premakumarahps/automotive-gearbox-machine-design/public/docs/ME3813_Presentation_Group11.pdf

# GEAR BOX

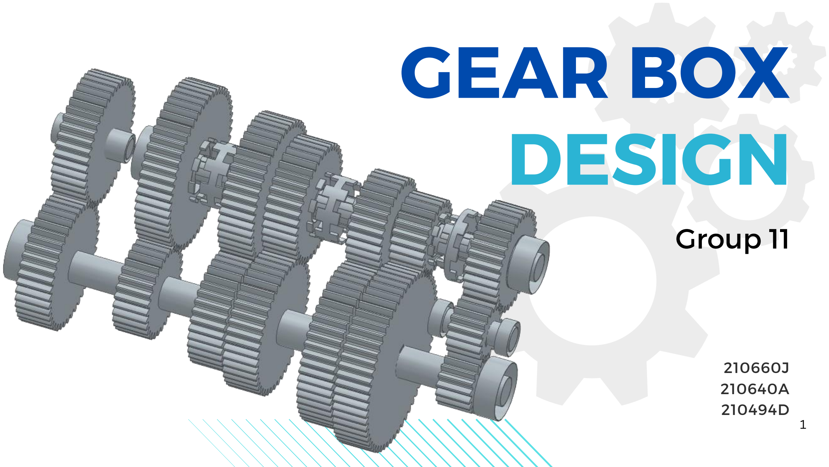
[picture p88: page 1]

# DESIGN

210660J
210640A
210494D

## Group 11

1

# VEHICLE SELECTION

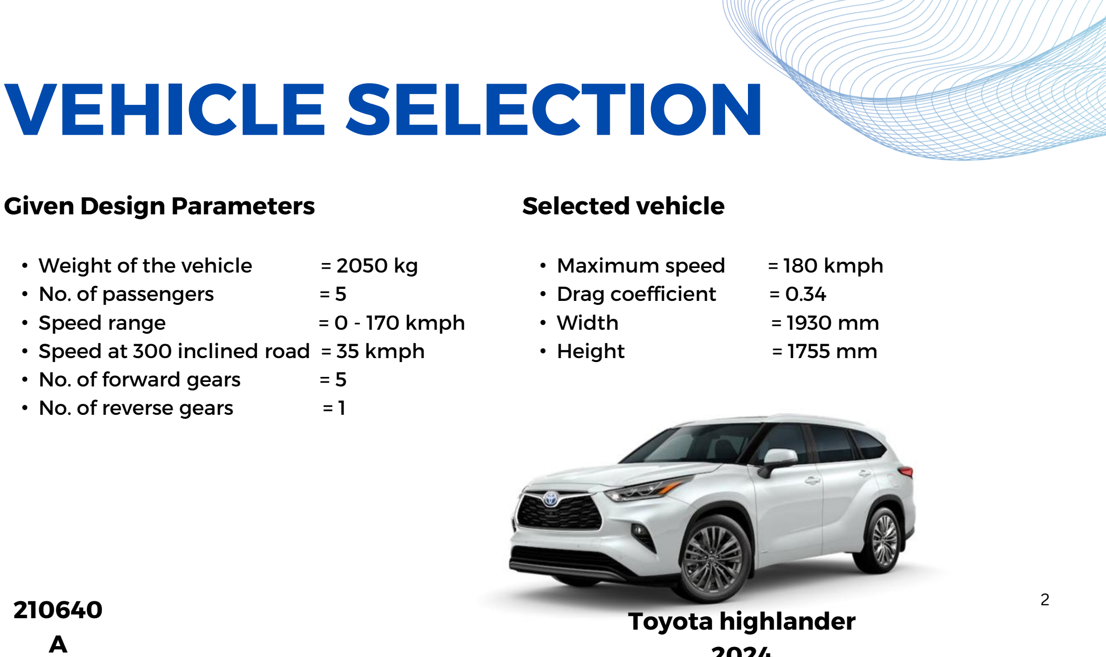
[picture p89: page 2]

Given Design Parameters

- Weight of the vehicle | = 2050 kg
- No. of passengers | = 5
- Speed range | = 0 - 170 kmph
- Speed at 300 inclined road = 35 kmph
- No. of forward gears | = 5
- No. of reverse gears | = 1

Selected vehicle

- Maximum speed | = 180 kmph
- Drag coefficient | = 0.34
- Width | = 1930 mm
- Height | = 1755 mm

2
210640
A

Toyota highlander
2024

# GEAR RATIO CALCULATION

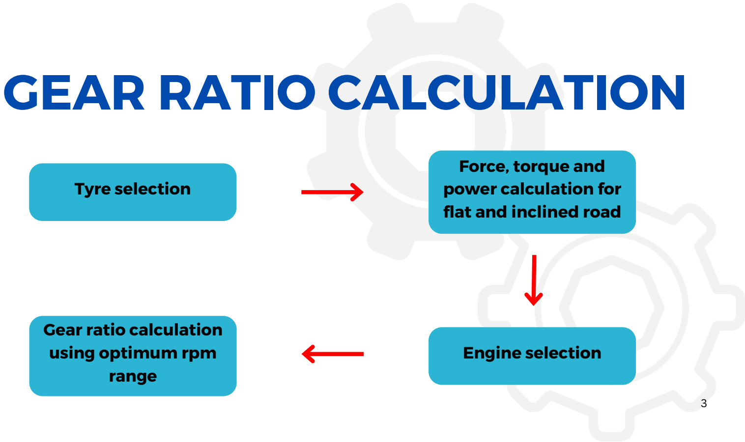
[picture p90: page 3]

Tyre selection

Force, torque and
power calculation for
flat and inclined road

Engine selection

Gear ratio calculation
using optimum rpm
range

3

# GEAR CALCULATION

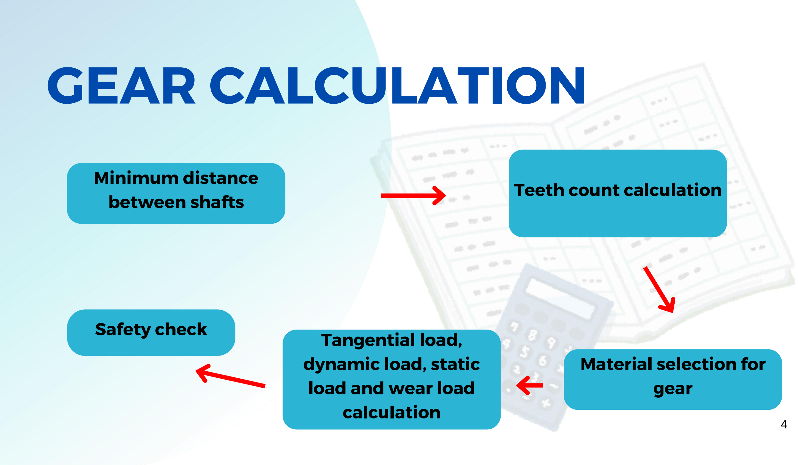
[picture p91: page 4]

Minimum distance
between shafts | Teeth count calculation

Material selection for
gear

Safety check
Tangential load,
dynamic load, static
load and wear load
calculation
4

# SHAFT CALCULATION

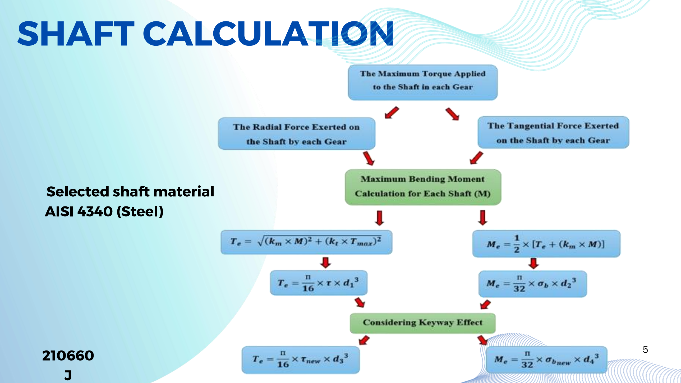
[picture p92: page 5]

Selected shaft material
AISI 4340 (Steel)

5
210660
J

# BENDING MOMENT CALCULATION

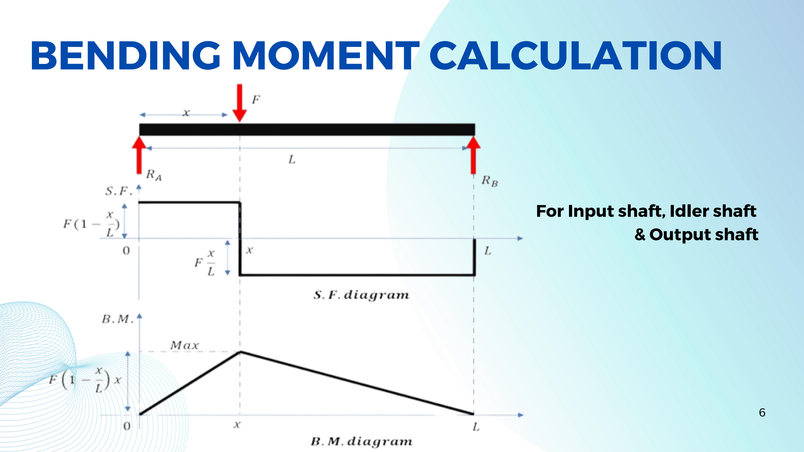
[picture p93: page 6]

For Input shaft, Idler shaft & Output shaft

6

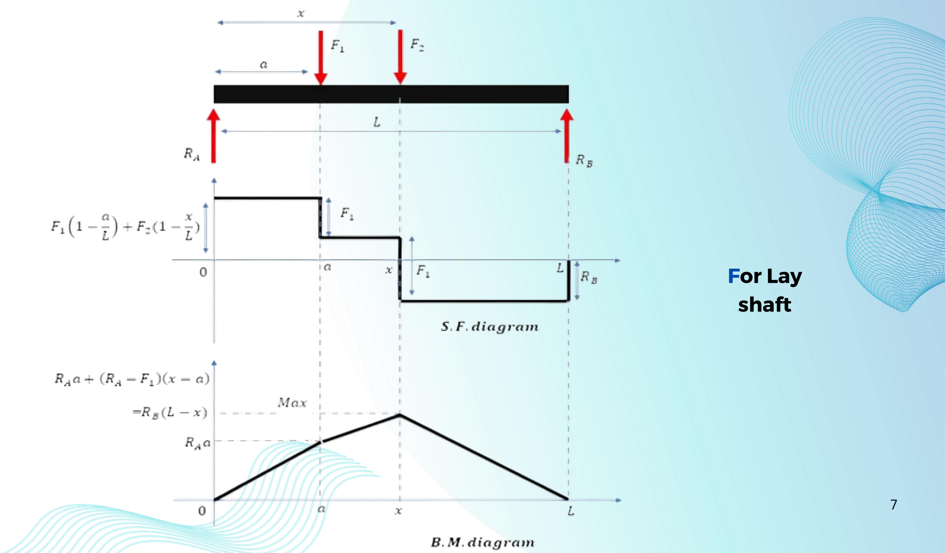
[picture p94: page 7]

For Lay
shaft

7

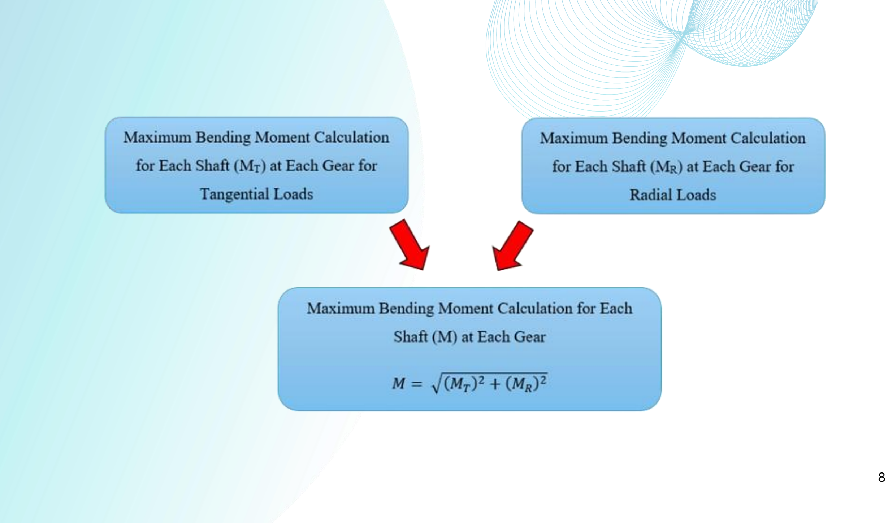
[picture p95: page 8]

8

# BEARING CALCULATIONS

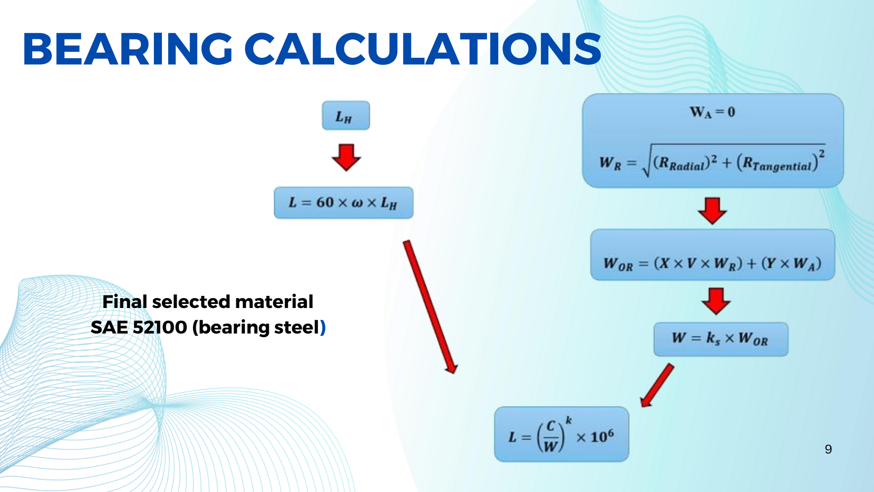
[picture p96: page 9]

Final selected material
SAE 52100 (bearing steel)

9

# SPLINE CALCULATION

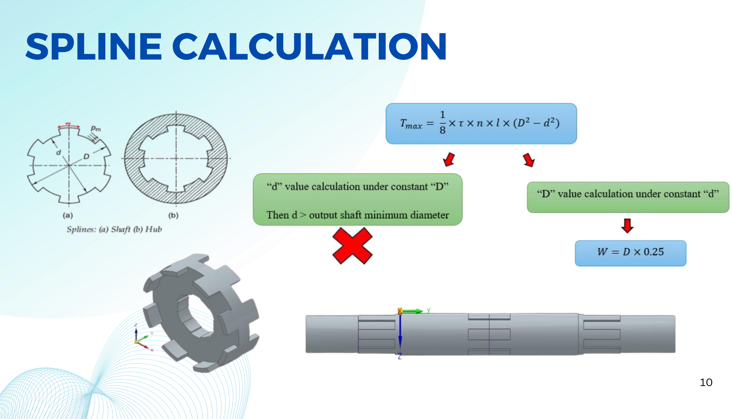
[picture p97: page 10]

10

# KEY CALCULATIONS

Determining width and
thickness

Calculating length

Keyway effect
calculation

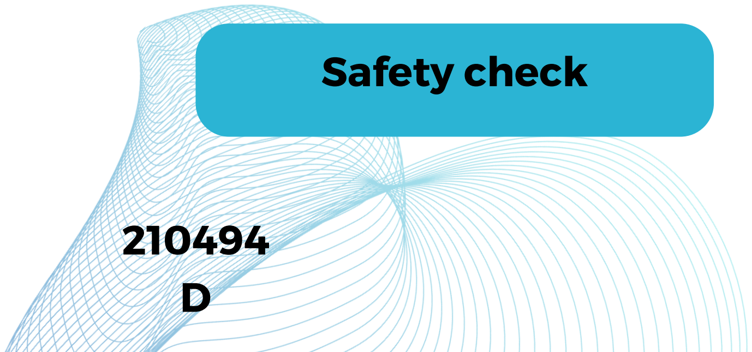
[picture p98: figure]
Safety check

210494 11

# LUBRICATION SYSTEM

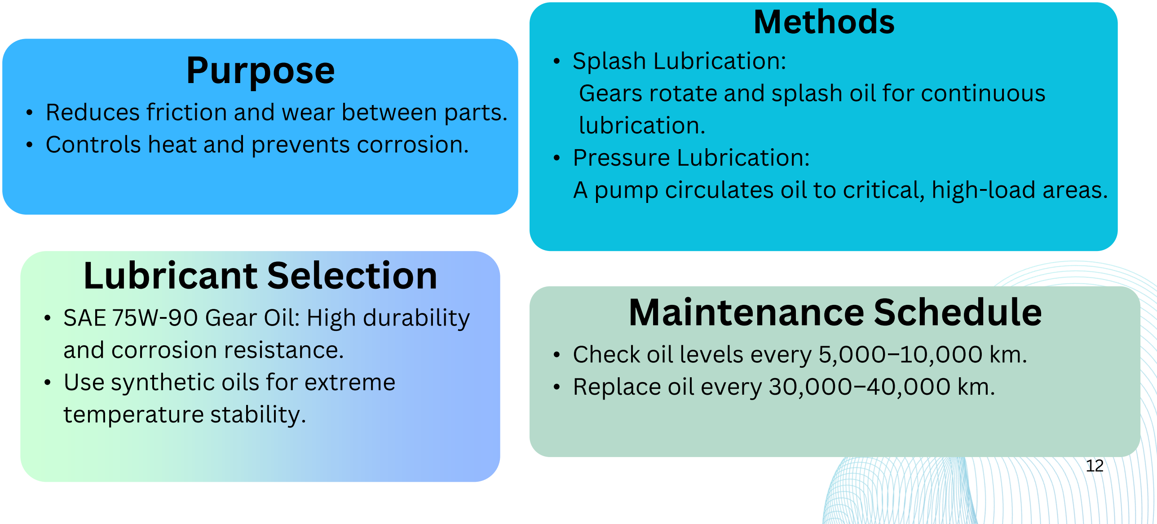
[picture p99: figure]
Maintenance Schedule; • Replace oil every 30,000–40,000 km.; Lubricant Selection; • SAE 75W-90 Gear Oil: High durability and corrosion resistance. • Use synthetic oils for extreme temperature stability.; Methods; • Splash Lubrication:; lubrication. • Pressure Lubrication:; Purpose; • Controls heat and prevents corrosion.

- Check oil levels every 5,000–10,000 km.

Gears rotate and splash oil for continuous

A pump circulates oil to critical, high-load areas.

- Reduces friction and wear between parts.

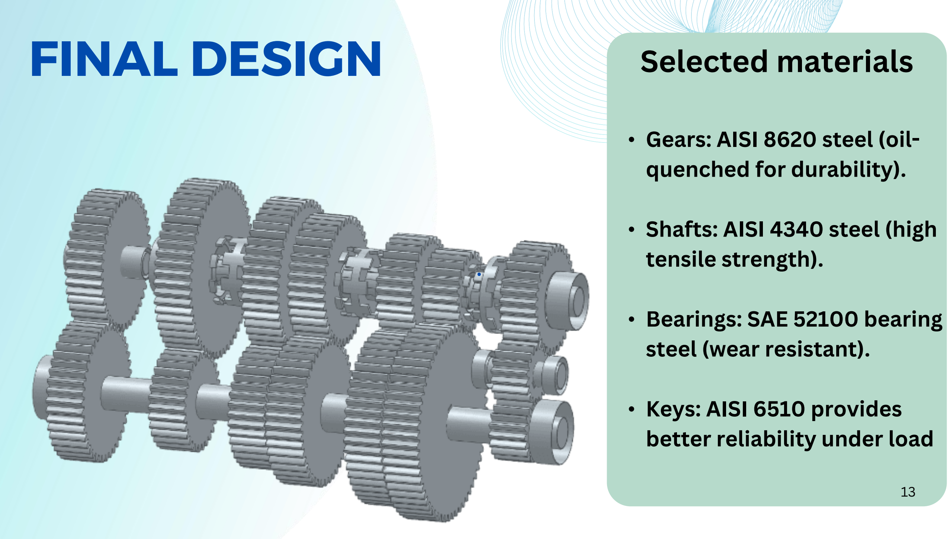
[picture p100: page 13]

FINAL DESIGN | Selected materials
- Gears: AISI 8620 steel (oil-quenched for durability).
- Shafts: AISI 4340 steel (high tensile strength).
- Bearings: SAE 52100 bearing steel (wear resistant).
- Keys: AISI 6510 provides better reliability under load

13

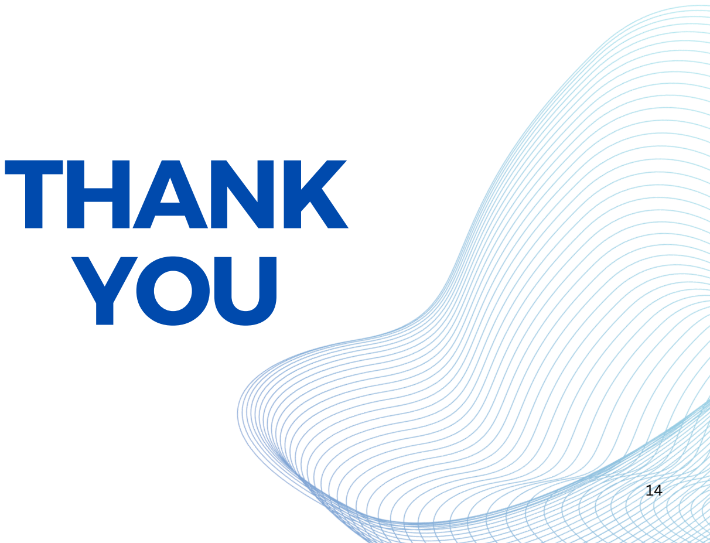
[picture p101: page 14]

# THANK YOU

14
