premakumarahps/automotive-gearbox-machine-design/public/docs/ME3813_Material_Selection.pdf

ME3813

## ME3813 Machine Design

## Semester 5

## Material Selection for Gearbox Components

By

Index No. | Name | Marks
210660J | UDAYAKANTHA D.A.W.I.
210640A | THEMIYA K.L.
210494D | PREMAKUMARA H.P.S.
Date of submission | 09/10/2024
Due date of submission | 09/10/2024

Department of Mechanical Engineering University of Moratuwa
Sri Lanka

### 01. INTRODUCTION

A gearbox is an essential mechanical system designed to transmit and modify rotational

energy from an engine to a driven component, effectively adjusting speed and torque. Given

the high stresses, friction, and temperature variations experienced during operation, the

selection of suitable materials is critical to ensuring the gearbox's reliability, performance,

and longevity. The chosen materials must possess specific mechanical properties, such as

strength, wear resistance, and fatigue endurance, to withstand harsh operating conditions

without failure. In addition to performance, the materials must be cost-effective,

manufacturable, and sustainable to ensure efficient production while meeting industry

standards and enhancing the overall performance of the gearbox.

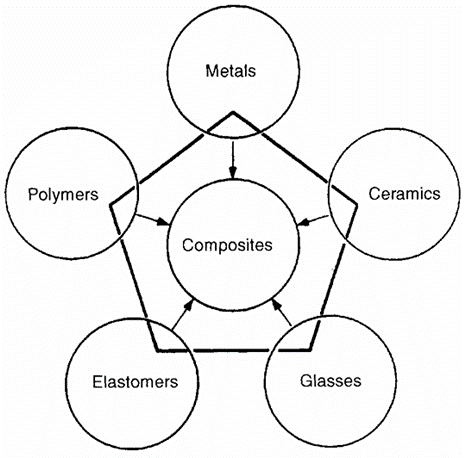
[picture p134: figure]

Figure 01: Types of materials [2]

02.MATERIAL PROPERTIES AND REQUIREMENTS

### 2.1 Mechanical properties

Mechanical properties are critical in determining how well a material can withstand forces and

stresses during operation. For gearbox components, essential properties include strength, which

ensures the material can handle loads without deforming; wear resistance, which is vital for

reducing material loss in high-friction areas like gears and bearings; and fatigue endurance,

which enables materials to resist failure after repeated cycles of stress over time.

### 2.2 Thermal properties

The thermal properties of materials dictate their performance under varying temperatures, a

common condition in gearboxes. High thermal conductivity is important to dissipate heat efficiently and avoid overheating. Materials with low thermal expansion help maintain their

dimensional stability despite temperature fluctuations, which is necessary to prevent

misalignment or damage in tightly-fitted components. Heat resistance ensures the material

remains strong and functional even at elevated operating temperatures.

### 2.3 Chemical properties

Chemical properties affect how materials interact with their environment, especially when

exposed to lubricants and other chemicals. Corrosion resistance is vital to protect materials

from degrading when exposed to moisture or chemicals, prolonging the life of components.

Oxidation resistance is equally important, particularly for materials used in high-temperature

environments, as it prevents deterioration from oxygen exposure, which can weaken

components over time.

### 2.4 Cost and availability

Cost and availability play a practical role in selecting materials. The chosen material should

provide the required performance at a reasonable cost to ensure economic feasibility, especially

in large-scale production. Additionally, the material should be readily available in sufficient

quantities to meet manufacturing demands without delays or supply chain issues, making it

more reliable for ongoing production.

### 2.5 Manufacturability

Manufacturability refers to the ease with which materials can be processed into final

components. Good machinability is essential for reducing production time and costs, allowing

materials to be efficiently cut, shaped, or drilled. Formability ensures materials can undergo

processes like casting or forging to achieve the desired shapes. Heat treatability allows

materials to be improved through thermal processes, enhancing their strength or wear resistance

where needed, especially for critical components like gears.

### 2.6 Durability and safety

Durability and safety are essential considerations for ensuring that gearbox components can

withstand prolonged use without failure. Durability involves the material’s ability to resist

wear, fatigue, and impact over time. Fatigue strength is particularly important for parts subject to cyclic loading, ensuring they do not crack or break under repeated stresses. Safety factors

ensure materials can handle unexpected loads or harsh conditions without failure, contributing

to the overall reliability of the system.

### 2.7 Environmental and sustainable factors

Sustainability is becoming an increasingly important consideration in material selection.

Recyclability is a key factor, as materials that can be repurposed or recycled at the end of their

lifecycle help reduce environmental impact. Energy efficiency, both in material production and

during operation, is another important aspect, as it can lower overall energy consumption.

Finally, using sustainably sourced materials helps ensure that environmental resources are

managed responsibly, aligning with industry trends towards greener production methods.

03.MATERIAL SELECTION FOR EACH COMPONENT

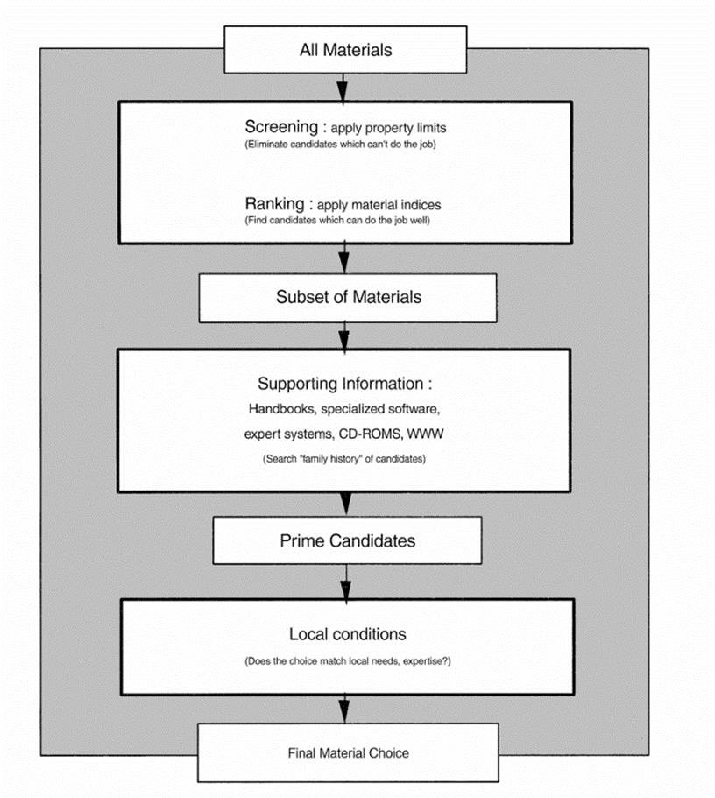
[picture p135: figure]

Figure 02 : Material selection procedure [2]

3.1GEARS

Material requirements :- High strength ,Wear resistance, Fatigue resistance, Toughness

Material options :- AISI 8620 (alloy steel), AISI 4140 (alloy steel), AISI 4340 (nickel-

chromium-molybdenum steel) [Figure 04] , [2] , [7] , [3] , [1]

Final selection - AISI 8620 (alloy steel, case-hardened)

This alloy steel offers excellent core toughness and can be case-hardened to improve surface

wear resistance. AISI 4140 or 4340 are also strong, tough steels but can be over-engineered or

expensive for standard gears.

Manufacturing considerations :- Case hardening to achieve a tough core and hard surface,

Precision machining for tooth profile accuracy, Surface finish for noise reduction

3.2SHAFTS

Material requirements :- High tensile strength, Toughness, Fatigue resistance, Machinability

Material options :- AISI 1045 (medium carbon steel), AISI 4140 (alloy steel), AISI 4340

(alloy steel) [Figure 04] , [2] , [7] , [1] , [6] , [Figure 06]

Final selection - AISI 1045 (medium carbon steel)

Medium carbon steel like AISI 1045 offers a good balance of machinability and strength, and

it can be heat-treated for better performance. AISI 4140 offers higher strength but may be

unnecessary for lower-stress applications.

Manufacturing considerations :- Easily machined, Heat-treatable for strength improvement,

Suitable for turning, Grinding, Drilling

3.3BEARINGS

Material requirements :- High wear resistance, Hardness, Fatigue strength, Low friction

Material options :- SAE 52100 (bearing steel), AISI 440C (stainless steel) [7] , [2] , [8] , [9]

, [5] , [Figure 03] , [Figure 07/05]

Final selection - SAE 52100 (bearing steel)

This is a standard bearing steel known for its hardness and wear resistance. Stainless steel (AISI

440C) is selected for corrosion resistance but comes with a cost and performance trade-off.

Manufacturing considerations :- Through-hardening for high durability, Precision grinding

for the rolling elements and raceways, Surface finish for friction reduction

3.4HOUSING

Material requirements :- Good vibration damping, Corrosion resistance, Machinability

Material options :- Cast Iron (ASTM A48) [8],[10][11], Aluminum alloy (6061) [12],[13]

[4],[2],[7] [Figure 04] , [Figure 06]

Final selection - Cast Iron (ASTM A48)

Cast iron offers excellent damping and machinability, making it ideal for gearbox housings.

Aluminum alloys like 6061 are lightweight alternatives but not as common in high-load

applications.

Manufacturing considerations :- Cast in complex shapes, Easy to machine, Excellent for

mass production, Aluminum can be an alternative for weight reduction (if required)

3.5SEALS AND GASKETS

Material requirements :- Good sealing ability, Flexibility, Chemical resistance, Temperature

resistance

Material options :- Nitrile rubber (Buna-N) [14],[15], Viton (fluoro elastomer)[16], PTFE

(Teflon) [17],[18],[2], [Figure 07/05]

Final selection - Nitrile rubber for general applications

Viton for high temperature or chemical resistance

It is economical, widely used, and provides good chemical resistance. Viton and PTFE are

selected for higher temperature or chemical resistance but at a higher cost.

Manufacturing considerations :- Injection molding for rubber seals, Die-cutting for gaskets,

Ensuring proper fit to prevent leaks

3.6FASTENERS

Material requirements :- High tensile strength, Corrosion resistance, Fatigue resistance

Material options :- Alloy steel (AISI 4140) [8],[19], Stainless steel (AISI 304 or AISI 316)

[20],[21],[2]

Final selection - Alloy steel (AISI 4140) for strength

Stainless steel for corrosion resistance in exposed areas

Alloy steel provides high strength for critical fasteners, and stainless steel (AISI 304 or 316) is

chosen for corrosion resistance when exposed to the environment.

Manufacturing considerations :- Cold forming or machining, Followed by heat treatment to

achieve required strength, Corrosion-resistant coatings may be added (if necessary)

3.7LUBRICATION SYSTEM COMPONENTS

Material requirements :- Chemical resistance to lubricants, Corrosion resistance,

Lightweight

Material options :- Steel (for critical parts) [2],[8] , Aluminum (for reservoirs) [22][23],

PTFE (for tubing or seals) [2],[17]

Final selection - Aluminum for weight reduction in non-load-bearing parts

Steel for high-stress components

Aluminum is lightweight for reservoirs, while steel is used for high-stress components. PTFE

is excellent for seals due to its chemical inertness.

Manufacturing considerations :- Extrusion for aluminum parts, Precision machining for steel

components, Corrosion-resistant coatings or anodizing for aluminum parts

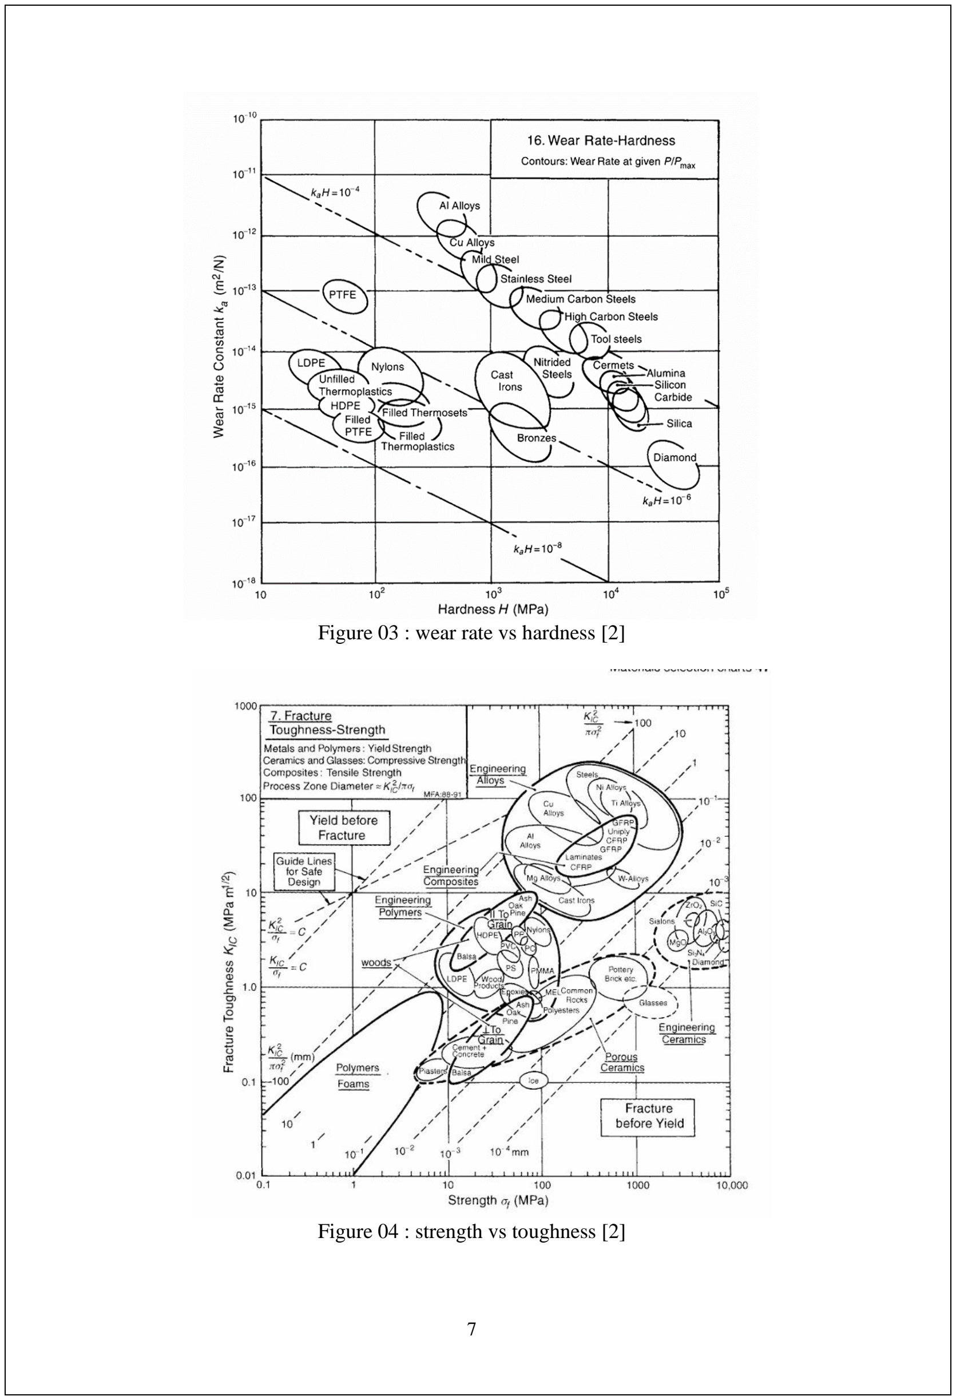
[picture p136: page 8]

Figure 03 : wear rate vs hardness [2]

Figure 04 : strength vs toughness [2]

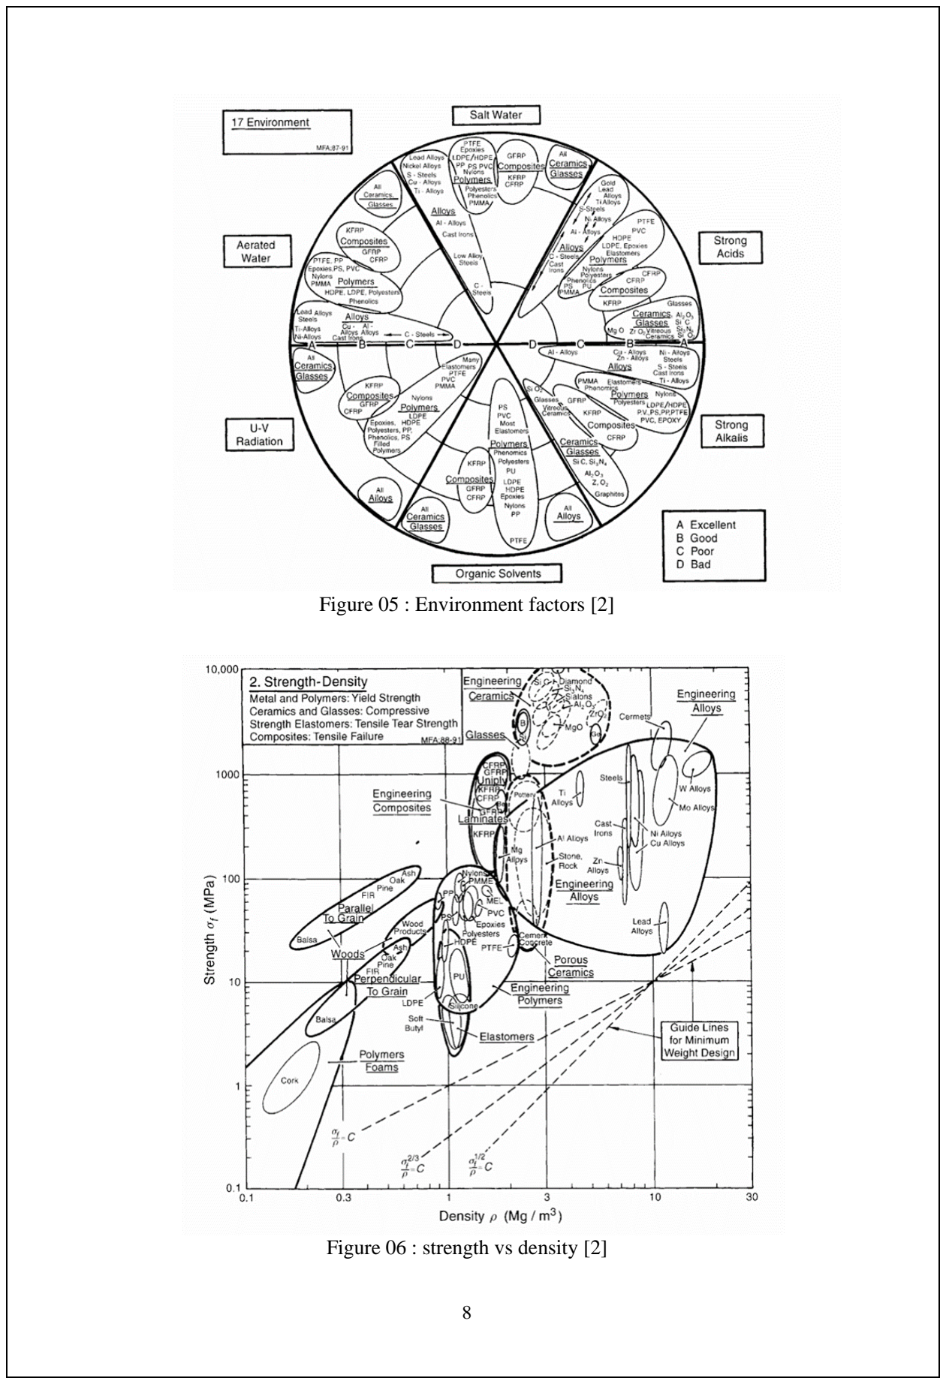
[picture p137: page 9]

Figure 05 : Environment factors [2]

Figure 06 : strength vs density [2]

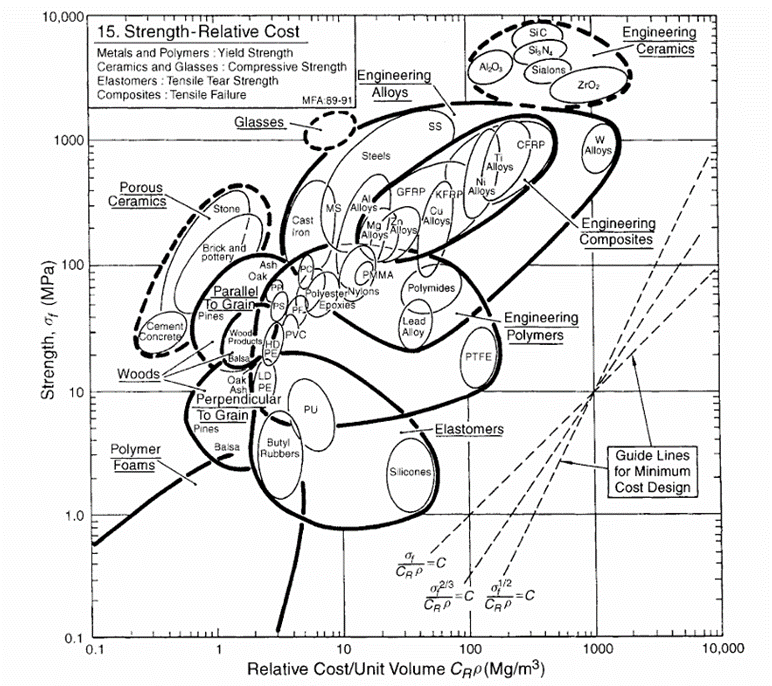
[picture p138: figure]

Figure 07 : strength vs cost [2]

### 04. CASE STUDY ANALYSIS

Component | Materials selected in our gearbox design | Marine Gearbox | Notes/Trade-offs
Gears | AISI 8620 (alloy steel, case-hardened) | Nickel-chromium-molybdenum steel alloys or stainless steel (AISI 316) | Stainless steel offers better corrosion resistance, but at a higher cost.
Shafts | AISI 1045 (medium carbon steel) | Duplex stainless steel or superalloys (e.g., Inconel) | Superalloys like Inconel provide superior corrosion and temperature resistance, increasing durability but also cost.
Bearings | SAE 52100 (bearing steel) | Ceramic Bearings (Silicon Nitride) | Ceramic bearings offer longer life and corrosion resistance but are more expensive.

Housing | Cast Iron (ASTM A48) | Aluminum-bronze alloys or marine-grade aluminum | Aluminum-bronze alloys are lighter and corrosion-resistant but less effective at damping vibrations.
Seals and Gaskets | Nitrile rubber for general applications, Viton | Nitrile Rubber (NBR), Fluoro elastomers (Viton), PTFE (Teflon), Silicone Rubber | Marine applications require enhanced chemical and temperature resistance, making Viton and PTFE preferable.
Fasteners | Alloy steel (AISI 4140) for strength, Stainless steel for corrosion resistance in exposed areas | AISI 316 Stainless Steel | Stainless steel fasteners are essential for corrosion resistance in marine environments, though more expensive.
Lubrication System Components | Aluminum for weight reduction, Steel for high-stress components | Marine-grade aluminum alloys (6061) for reservoirs, PTFE (Teflon) for seals | Marine-grade aluminum offers corrosion resistance, and PTFE seals withstand chemicals and temperatures effectively.

05.CONCLUSION

In this report, we explored the importance of material selection in gearbox design. Components

such as gears and lubrication systems require specific properties like strength, wear resistance,

and thermal stability, with cost and sustainability also playing a role.

In marine gearboxes, corrosion resistance leads to the use of specialized, often more expensive,

materials like stainless steel and superalloys. Proper material selection can greatly improve

performance and durability in harsh conditions.

Understanding these materials allows engineers to optimize gearbox designs for better

performance and longevity across different environments.

### 06. REFERENCE

1) Davis, Joseph R. Gear Materials, Properties, and Manufacture. ASM International, 2005.
2) Ashby, Michael F. Materials Selection in Mechanical Design. 5th ed., Butterworth-Heinemann, 2016.
3) Shigley, Joseph Edward, Charles R. Mischke, and Richard Gordon Budynas. Mechanical Engineering Design. Revised ed., McGraw Hill Professional, 2004.
4) “SAE J434 for Automotive Ductile (Nodular) Iron Castings.” Available: https://www.ironfoundry.com/sae-j434-automotive-ductile-iron-castings.html Accessed: 03/10/2024.
5) “ASTM SAE AISI 52100 Steel Properties, Composition, Equivalent,” World Material. Available: https://www.theworldmaterial.com/astm-sae-aisi-52100-bearing-steel/ Accessed: 03/10/2024.
6) Chironis, Nicholas P. Gear Design and Application. McGraw-Hill, 1967. Digitized by University of California, 28 Mar 2011.
7) Stokes, Alec. Manual Gearbox Design. Illustrated ed., Butterworth-Heinemann, 1992.
8) ASM Handbook: Properties and Selection: Irons, Steels, and High-Performance Alloys.
ASM | International, | | Volume | 1, | 1990. | DOI:
https://doi.org/10.31399/asm.hb.v01.9781627081610. ISBN: 978-1-62708-161-0. Accessed: 03/10/2024.
9) ISO 683-17:2023(en), Heat-Treatable Steels, Alloy Steels, and Free-Cutting Steels – Part 17: Ball and Roller Bearing Steels. Accessed: 03/10/2024.
10) West, Thomas Dyson. Metallurgy of Cast Iron: A Complete Exposition of the Processes Involved in Its Treatment, Chemically and Physically, from the Blast Furnace Through the Foundry to the Testing Machine. Cleveland Printing and Publishing Company, 1897. Digitized by New York Public Library, 2 May 2006.
11) Juneja, B. L. Fundamentals of Metal Forming Processes. New Age International, 2007.
12) Hatch, John E. Aluminum: Properties and Physical Metallurgy. Volume 1 of Aluminum / J.E. Hatch Hrsg. American Society for Metals, ASM International, 1984.
13) ASM Handbook: Properties and Selection: Nonferrous Alloys and Special-Purpose
Materials. | Volume | 2, | ASM | International, | 1990. | DOI:
https://doi.org/10.31399/asm.hb.v02.9781627081627. ISBN electronic: 978-1-62708-162-7. Accessed: 06/10/2024.
14) Morton, Maurice. Rubber Technology. Springer Science & Business Media, 2012.
15) Parker O-Ring Handbook. 50th Anniversary Edition, Parker Hannifin Corporation, Lexington, KY.

16) Drobny, Jiri George, and Albert L. Moore. Fluoroelastomers Handbook: The Definitive User's Guide. Revised ed., William Andrew, 2005.
17) Ebnesajjad, Sina. Fluoroplastics, Volume 1: Non-Melt Processible Fluoropolymers - The Definitive User's Guide and Data Book. 2nd ed., William Andrew, 2014.
18) Flinn, Richard Aloysius, and Paul K. Trojan. Engineering Materials and Their Applications. 3rd ed., Houghton Mifflin, 1986.
19) Totten, George E. Steel Heat Treatment: Metallurgy and Technologies. 2nd ed., illustrated and revised, CRC Press, 2006.
20) Cramer, Stephen D., and Bernard S. Covino Jr., editors. ASM Handbook Volume 13A: Corrosion: Fundamentals, Testing, and Protection. ASM International, Product code: 06494G.
21) Beddoes, Jonathan, and James Gordon Parr. Introduction to Stainless Steels. 3rd ed., illustrated, ASM International, 1999.
22) Singh, D.K. Fundamentals of Manufacturing Engineering. 3rd ed., revised, Ane Books, 2014.
23) Davis, Joseph R., editor. ASM Specialty Handbook: Aluminum and Aluminum Alloys. ASM International, 1993.
24) “The Materials Cube | Ansys.” Accessed: 03/10/2024. [Online]. Available:

https://www.ansys.com/academic/educators/education-resources/the-materials-cube
