premakumarahps/automotive-gearbox-machine-design/(commit log)

2026-09-26 feat: initial commit for 5-speed automotive gearbox kinematic and mechanical design
    [Final Assembly.cfg]
2026-09-27 refactor: restructure repository to make web app root-level with project_archive subfolder
    [Final Assembly.cfg]
2026-09-27 Install and Configure Vercel Web Analytics
    Implemented Vercel Web Analytics for the automotive gearbox machine design project.
    ## Changes Made
    ### 1. Installed @vercel/analytics Package
    - Added `@vercel/analytics` version ^2.0.1 to project dependencies
    - Package installed using npm and properly added to package.json
    ### 2. Integrated Analytics Component in App.tsx
    - Imported Analytics component from '@vercel/analytics/react'
    - Added `<Analytics />` component at the end of the App component (before the closing div)
    - Placed after the Footer component to ensure analytics tracking across all pages/tabs
    ### 3. Modified Files
    - **package.json**: Added @vercel/analytics to dependencies
    - **pac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
